kkruege/Community-Sensor-Lab/README.md

# citizen-sensors

/*
 Welcome to our ASRC Citizen Sensors Community! We're still building this space but feel free to utilize the materials available.
 Contents:
 
 --CO2 Arduino Code Explanation: A break down of the different sections of code for coding beginners
 
 --Citizen Sensors-DIY CO2 How To.pdf : A step by step guide to creating your own DIY CO2 Sensor
 
 --Co2 Sensor Materials and Purchasing List.xlsx : Spreadsheet of all the materials and links to purchase

--Code-README.md : Readme for the RTC_SD_LCD_K30_v1.1.ino code

--Intro to Calibrating CO2 sensors (1).pdf : How to Calibrate the CO2 Sensor. (most new sensors don't need to be calibrated, but it's a good check)

--Components and Assembly Curriculum : A 2 hours workshop guide to assemble and test the CO2 Sensors. (all modifications will need to be completed in the how-to guide before this)

--RTC_SD_LCD_K30_v1.1.ino : Arduino code to run the fully assembled system

--readCO2.ino : Simple code to read in value from the CO2 Sensor and Arduino only

Check out our demo video at https://youtu.be/BxUkMSFgT1w

Contact kkrueger@gc.cuny.edu if you have any questions we'll try to answer!

*/
