kkruege/Community-Sensor-Lab/pdfs/CO2 Arduino Code Explanation.pdf

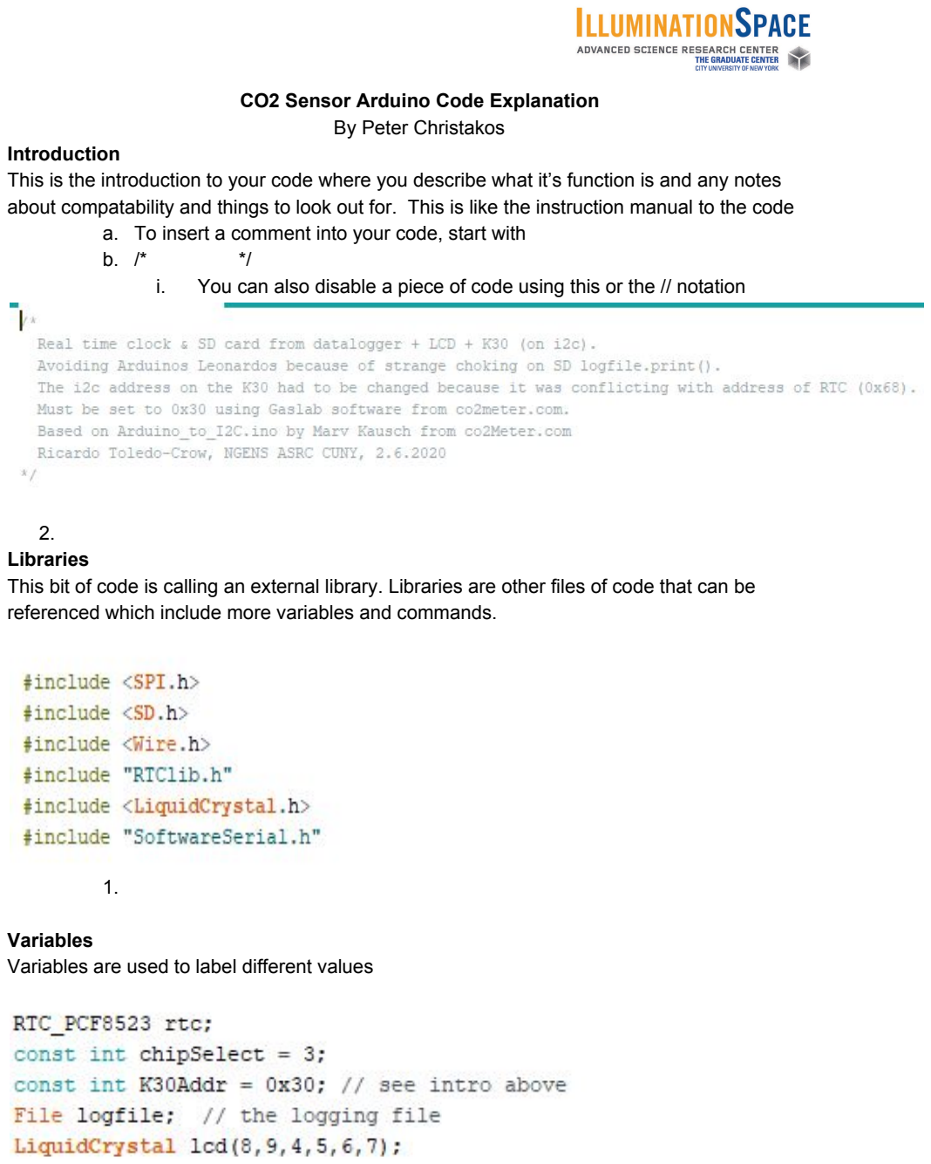
[picture p1: page 1]

CO2 Sensor Arduino Code Explanation By Peter Christakos
Introduction
This is the introduction to your code where you describe what it’s function is and any notes about compatability and things to look out for. This is like the instruction manual to the code
a. To insert a comment into your code, start with
b. /* | */
i. You can also disable a piece of code using this or the // notation

2.
Libraries
This bit of code is calling an external library. Libraries are other files of code that can be referenced which include more variables and commands.

1.

Variables
Variables are used to label different values

Setup
The set up defines different parameters and conidtions for each component

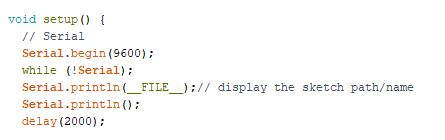
[picture p2: figure]

//Serial Communication: This tells the arduino to exchange information at 9600 bits per second, With a delay of 2000.

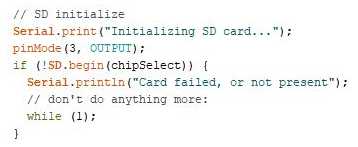
[picture p3: figure]

//SD Card Storage: Starts the use of the SD card to store the data being given. But if there is no SD card in the arduino it will not do anything at all.

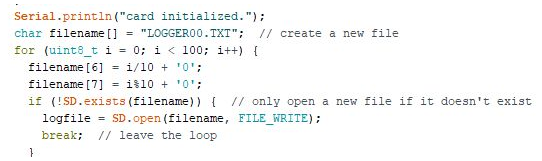
[picture p4: figure]

//Creates a file to display the information that is being given off by the arduino. Does not open another display if one already exist.

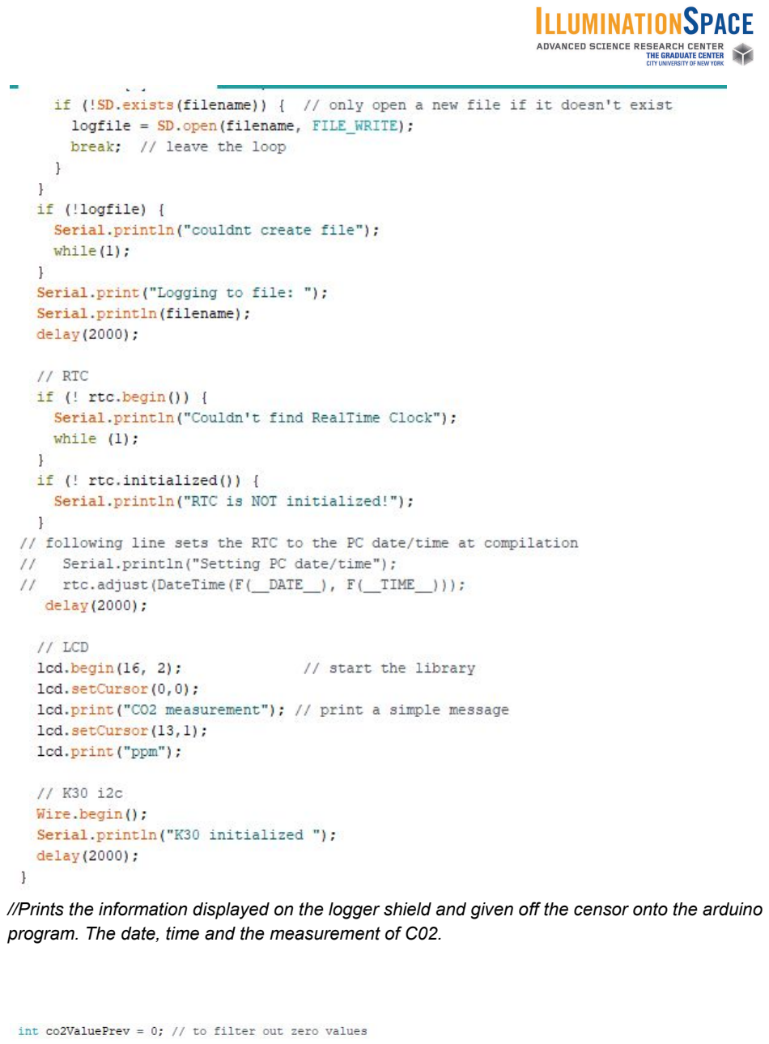
[picture p5: page 3]

//Prints the information displayed on the logger shield and given off the censor onto the arduino program. The date, time and the measurement of C02.

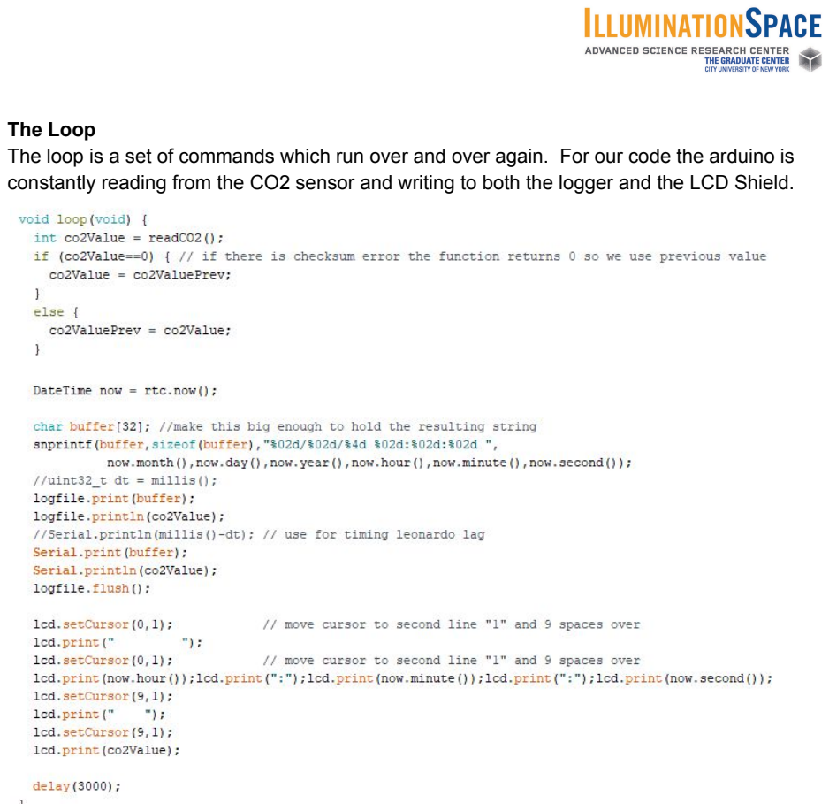
[picture p6: page 4]

The Loop
The loop is a set of commands which run over and over again. For our code the arduino is constantly reading from the CO2 sensor and writing to both the logger and the LCD Shield.
