kkruege/Community-Sensor-Lab/Co2 Sensor Materials and Purchasing List.xlsx

Sensor Budget for 16 Sensors (1 class)
vendor | item | link | Unit Price | QT | Total
Amazon | multimeters | https://www.amazon.com/WinnerEco-Digital-Multimeter-Tester-Yellow/dp/B01N95MSWV?s=automotive | 4.6 | 16 | 73.6
amazon | breadboard | https://www.amazon.com/DEYUE-breadboard-Set-Prototype-Board/dp/B07LFD4LT6?s=electronics | 9.59 | 2 | 19.18
amazon | jumper cables | https://www.amazon.com/AUSTOR-Lengths-Assorted-Preformed-Breadboard/dp/B07CJYSL2T | $10.99 | 1 | 16
amazon | jumper cables | https://www.amazon.com/GenBasic-Solderless-Dupont-Compatible-Breadboard-Prototyping/dp/B01L5UJ36U | $5.99 | 1 | $5.99
amazon | Logger Shield | https://www.amazon.com/Adafruit-Assembled-Logging-Shield-Arduino/dp/B00OKCRZ7A | $13.89 | 16 | $222.24
amazon | Arduino Uno | https://www.amazon.com/ELEGOO-Board-ATmega328P-ATMEGA16U2-Compliant/dp/B01EWOE0UU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 | $13.98 | 16 | $223.68
amazon | Case | https://www.amazon.com/gp/product/B00IOVQDYE/ref=ppx_yo_dt_b_asin_title_o00_s00?ie=UTF8&psc=1 | $18.68 | 4 | $74.72
amazon | Battery | https://www.amazon.com/LiCB-Pack-CR1220-Lithium-Battery/dp/B0797NRXZY | $6.99 | 1 | $6.99
amazon | SD Card | https://www.amazon.com/Kingston-microSDHC-Memory-SDC4-8GBET/dp/B00200K1TS?s=grocery | $3.99 | 16 | $63.84
amazon | Power Adapter | https://www.amazon.com/Super-Power-Adapter-Charger-Electronics/dp/B013J3BTA4 | $11.38 | 16 | $182.08
amazon | LCD Shield | https://www.amazon.com/Velleman-VMA203-Keypad-Arduino-Multi-Colour/dp/B01N7XP4ZR?s=electronics | $17.07 | 16 | $273.12
CO2Meter | K30 CO2 Sensor | https://www.co2meter.com/collections/0-1-co2/products/k-30-co2-sensor-module | $85.00 | 16 | $1360.00
amazon | SD to USB | https://www.amazon.com/Anker-Portable-Reader-RS-MMC-Micro/dp/B006T9B6R2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 | 9.99 | 16 | $159.84
 | Male female Header pins | https://www.amazon.com/2-54mm-Breakaway-Female-Connector-Arduino/dp/B01MQ48T2V | 8.49 | 1 | $8.49
 | Header Pins | https://www.amazon.com/ADAFRUIT-INDUSTRIES-85-STACKING-COMPATIBLE/dp/B00LB76EVU | $4.75 | 10 | $47.50
amazon | Serial connector | https://www.amazon.com/ADAFRUIT-Industries-954-Serial-Raspberry/dp/B00DJUHGHI?s=electronics | 12.25 | 2 | $24.50
amazon | USB A to B | https://www.amazon.com/Cable-Matters-3-Pack-USB-Printer/dp/B00UNZ9HLU?rnid=7800923011&s=pc | 9.99 | 1 | $9.99
 | Velcro
 | Office supplies (incidentals)
 |  | Total | 212.14 | Total | 2771.76
