kkruege/Community-Sensor-Lab/FeatherM0_RTC_SD_SCD30-CO2_OLED_BME280/initializeBME.ino

// Adafruit BME280 T P RH sensor

void initializeBME()  {
  unsigned status = bme.begin();
  // You can also pass in a Wire library object like &Wire2
  // status = bme.begin(0x76, &Wire2)
  if (!status) {
    Serial.println("Could not find a valid BME280 sensor, check wiring, address, sensor ID!");
    Serial.print("SensorID was: 0x"); Serial.println(bme.sensorID(), 16);
    Serial.print("        ID of 0xFF probably means a bad address, a BMP 180 or BMP 085\n");
    Serial.print("   ID of 0x56-0x58 represents a BMP 280,\n");
    Serial.print("        ID of 0x60 represents a BME 280.\n");
    Serial.print("        ID of 0x61 represents a BME 680.\n");
    //while (1) delay(10);
  }
  else
    Serial.println("BME ok");
}
