kkruege/Community-Sensor-Lab/FeatherM0_RTC_SD_SCD30-CO2_OLED_BME280/arduino_secrets.h

// NGENS lab wifi
#define SECRET_SSID "NGENSPC1"
#define SECRET_PASS "N63n5adm1n"

// Ricardo's home wifi
//#define SECRET_SSID "Gardsnas"
//#define SECRET_PASS "60n2al0T0l3d0"

// Amalia's home wifi
//#define SECRET_SSID "SpectrumSetup-D0"
//#define SECRET_PASS "sleepylawn337"
