kkruege/Community-Sensor-Lab/FeatherM0_RTC_SD_SCD30-CO2_OLED_BME280/toggleButton.ino

bool toggleButton(uint8_t button, bool state, bool& buttonState, int& prevTime, int debounce )  {

  if (digitalRead(button))  {
    buttonState = true;
//    Serial.print("buttonState "); Serial.println(buttonState);
    return state;
  }
  else if (buttonState && millis() - prevTime > debounce) {
    buttonState = false;
    prevTime = millis();
//    Serial.print("buttonState "); Serial.println(buttonState);
    return !state;
  }
  else
    return state;
}
