kkruege/Community-Sensor-Lab/(commit log)

2020-05-11 Calibration Protocol
    A step by step process on how to calibrate your CO2 sensors before using them for any project!
2020-05-11 Calibration Protocol
    A step by step on how to calibrate your CO2 sensors!
2021-03-18 Update arduino_secrets.h
    added used wifi networks
2021-03-18 Delete printWiFiStatus.ino
    put into wifiSetup()
